Rennaafi/rplidar-zybo/(commit log)

2026-09-28 Add RPLIDAR A1 to Zybo Z7-10 bare-metal scanner
    PL: AXI UART Lite + AXI GPIO + motor_pwm on Pmod JE, built by one Tcl script.
    PS: non-blocking bare-metal app with a noise-hardened scan parser.
    PC: bench test, live polar viewer, fake lidar, and wiring sniffer.
    [build_sw.py, fake_lidar.py, lidar_parse.c, lidar_parse.h, lidar_view.py, lidar_zybo.xdc, main.c, motor_pwm.v]
2026-10-04 Add console bridge: fake and real lidar through the Zybo parser to the viewer
    FAKE_SRC build takes scan bytes from the console UART; lidar_view.py gains
    --bridge/--source. Fixes the polar plot radius collapsing to ~0. Adds
    screenshots and README status rows.
    [lidar_view.py, main.c]
2026-10-08 Direct lidar link verified on hardware; duty sweep, default duty 120
    Lidar wired to Pmod JE (TX JE1, RX JE2, MOTOCTL JE3): ~7.1 Hz, ~280 pts/rev,
    0 overruns. Sweep duty 40-255 shows a fixed ~1980 samples/s, so duty only
    trades rate against angular resolution. DUTY_DEFAULT 200 -> 120.
    [main.c]
2026-10-09 Add Vivado/Vitis GUI walkthrough; fix sync false-positive rate (1 in 4)
    [lidar_parse.h]
